lhr-solar/Telemetry/README.md

# Telemetry
Legacy Telemetry Code from BeVolt. Some of this might be useful as a reference for development of future telemetry systems.
