lhr-solar/Telemetry/Senior Design Project 2017/Source Code/STM_Acquisition/nucleo data flow and sw structure.pptx

## Nucleo Acquisition S/W Structure

Main Thread

Initialization

Internal Sensor N

Sample Period

Last Sample Timestamp

DATA

Flag Raised?

FIFO Not Empty?

Create CAN messages Periodic Timer

System Timer

Raises Flag

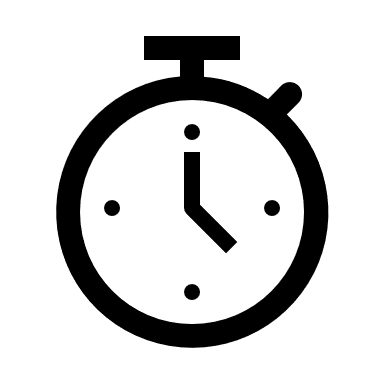
[picture p1: figure]
Stopwatch

Sensor Manager Class

Data

Data

Data

Data

CAN Message Queue Class

CAN Message FIFO

CAN CONTROLLER (WIP)

Input Control

CAN Receive Message
(i.e. Time Sync, etc.)

ID

Output Control

Sensor Data Output on CAN BUS

ID

ID

ID

ID

True

True

## Slide 2

Sensor Class Structure

Sensor Communication Objects
(SPI, I2C, Serial, CAN, Ethernet, … )

Public Functions
Init();
readSensor(timeout_state* pToState, char* pData);
getSizeOfData();

Child Sensor Class

Private Functions
Usually supplied by library as helper functions

SvtSensor Class

bool timeToSample();
void sampleSensor(char * pData);

<Specific> Child Sensor Class
Virtual functions
Init();
readSensor(timeout_state* pToState, char* pData);
getSizeOfData();

ID

Timeout

Sample Period

Last Sample Timestamp

Internal Sensor N

Sample Period

Last Sample Timestamp

DATA

ID

## Open House In-Car Structure

GPS Serial Data

Daughter Board

STM Nucleo

CAN

Send UDP over Ethernet

BPS Serial Data

RPi Hat

Raspberry Pi 3

9DOF I²C Data

Daughter Board

STM Nucleo

Luminosity I²C Data
