lhr-solar/Telemetry/Senior Design Project 2017/Source Code/STM_Acquisition/ourDocumentationImages/nucleo data flow and sw structure.pptx

Main Thread

Initialization

Internal Sensor Data Acquisition

Initialization

CAN Message Creator Thread

Initialization

Timer -> create an array of CAN Messages to reflect the current Sensor States
Sleep Till Timer Event

CANager Thread

Initialization

Timer -> send CAN the next CAN message once the CAN bus is available
Sleep Till Timer Event

Sensor Data Output on CAN BUS

Sensor Bus Protcol #X

External Sensor Data Acquisition
(Timer -> collect data)
Sleep Till Timer Event

Nucleo Data State Class

Data Lock

Sensor Data

CAN Message Queue Class

Data Lock

CAN Message Fifo

## Open House In-Car Structure

GPS Serial Data

Daughter Board

STM Nucleo

CAN

Send UDP over Ethernet

BPS Serial Data

RPi Hat

Raspberry Pi 3

9DOF I²C Data

Daughter Board

STM Nucleo

Luminosity I²C Data

## Slide 3

Main Thread

Initialization

Internal Sensor Data Acquisition

Initialization

CAN Message Creator Thread

Initialization

Timer -> create an array of CAN Messages to reflect the current Sensor States
Sleep Till Timer Event

CANager Thread

Initialization

Timer -> send CAN the next CAN message once the CAN bus is available
Sleep Till Timer Event

Sensor Data Output on CAN BUS

Sensor Bus Protcol #X

External Sensor Data Acquisition
(Timer -> collect data)
Sleep Till Timer Event

Nucleo Data State Class

Data Lock

Sensor Data

CAN Message Queue Class

Data Lock

CAN Message Fifo
