lhr-solar/Telemetry/Senior Design Project 2017/Source Code/STM_Acquisition/STM1.csv

Timestamp, | LIGHT, | ORIENTATION, | GPS,
0, | , | 0, | -90 -59 984 , | 0, | , | 0, | , | 0, | , | 0, | , | 0, | , | 0, | , | 0, | , | 0, | ,
1510002781, | , | 1510002781, | -81 -69 981 , | 1510002781, | , | 1510002781, | , | 1510002781, | , | 1510002781, | , | 1510002781, | , | 1510002781, | , | 1510002781, | , | 1510002781, | ,
1510002782, | , | 1510002782, | -82 -65 982 , | 1510002782, | , | 1510002782, | , | 1510002782, | , | 1510002782, | , | 1510002782, | , | 1510002782, | , | 1510002782, | , | 1510002782, | ,
1510002783, | , | 1510002783, | -80 -68 979 , | 1510002783, | , | 1510002783, | , | 1510002783, | , | 1510002783, | , | 1510002783, | , | 1510002783, | , | 1510002783, | , | 1510002783, | ,
1510002784, | , | 1510002784, | -82 -66 980 , | 1510002784, | , | 1510002784, | , | 1510002784, | , | 1510002784, | , | 1510002784, | , | 1510002784, | , | 1510002784, | , | 1510002784, | ,
0, | , | 0, | -81 -67 980 , | 0, | , | 0, | , | 0, | , | 0, | , | 0, | , | 0, | , | 0, | , | 0, | ,
1510002786, | , | 1510002786, | -80 -66 981 , | 1510002786, | , | 1510002786, | , | 1510002786, | , | 1510002786, | , | 1510002786, | , | 1510002786, | , | 1510002786, | , | 1510002786, | ,
1510002787, | , | 1510002787, | -80 -67 978 , | 1510002787, | , | 1510002787, | , | 1510002787, | , | 1510002787, | , | 1510002787, | , | 1510002787, | , | 1510002787, | , | 1510002787, | ,
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
1510002804, | , | 1510002804, | -76 -73 980 , | 1510002804, | , | 1510002804, | , | 1510002804, | , | 1510002804, | , | 1510002804, | , | 1510002804, | , | 1510002804, | , | 1510002804, | ,
