lhr-solar/Telemetry/RP3 Demo/grafana-dash.png

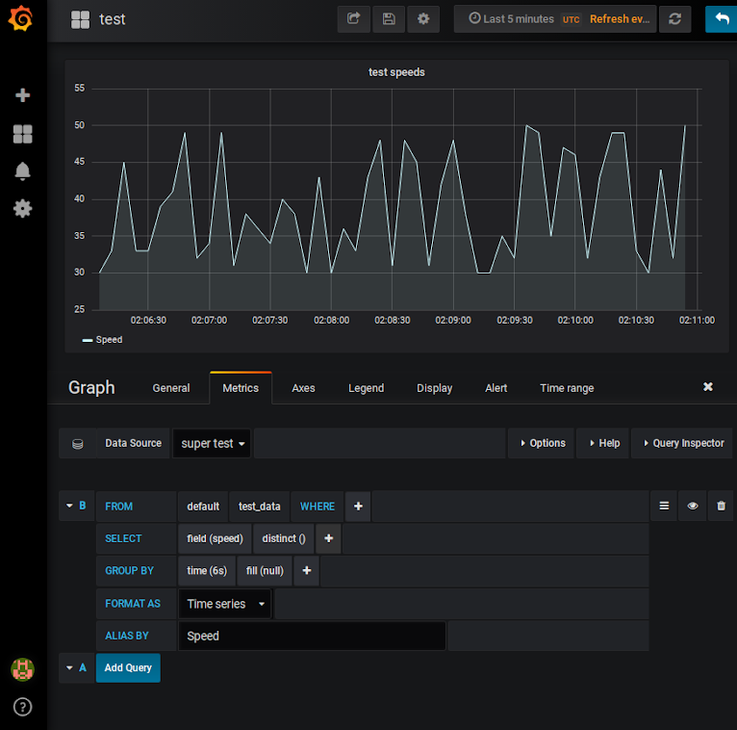
RP3 Demo/grafana-dash.png
