lhr-solar/Telemetry/RP3 Demo/grafana_settings.png

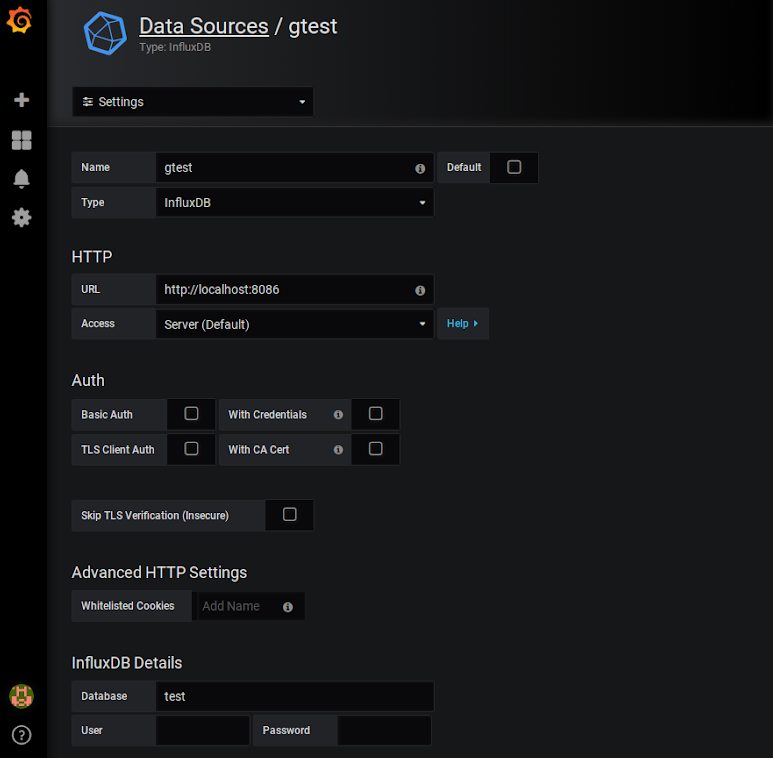
RP3 Demo/grafana_settings.png
