lhr-solar/Telemetry/Senior Design Project 2017/Source Code/Display/TestingLogs/concurrent.xlsx

Seconds | InfluxDB |  |  |  |  | Grafana |  |  |  |  | Python
 | VIRT | RES | SHR | %CPU | %MEM | VIRT | RES | SHR | %CPU | %MEM | VIRT | RES | SHR | %CPU | %MEM
0 | 824424 | 50824 | 10056 | 0 | 5.4 | 900836 | 26852 | 14756 | 0 | 2.8 | 16812 | 13016 | 6220 | 0 | 1.4
5 | 824424 | 50824 | 10056 | 3 | 5.4 | 900836 | 26852 | 14756 | 0.4 | 2.8 | 16812 | 13016 | 6220 | 1.2 | 1.4
10 | 824424 | 50824 | 10056 | 1 | 5.4 | 900836 | 26852 | 14756 | 0.2 | 2.8 | 16812 | 13016 | 6220 | 1.4 | 1.4
15 | 824424 | 51836 | 10444 | 15.9 | 5.5 | 900836 | 26852 | 14756 | 1.4 | 2.8 | 16812 | 13016 | 6220 | 1.2 | 1.4
20 | 824424 | 57696 | 10848 | 75.6 | 6.1 | 900836 | 26852 | 14756 | 1.4 | 2.8 | 16812 | 13016 | 6220 | 1.6 | 1.4
25 | 824424 | 57696 | 10848 | 3 | 6.1 | 900836 | 26852 | 14756 | 0.4 | 2.8 | 16812 | 13016 | 6220 | 1.6 | 1.4
30 | 824424 | 67560 | 10988 | 165.9 | 7.1 | 900836 | 26852 | 14756 | 1.4 | 2.8 | 16812 | 13016 | 6220 | 1.6 | 1.4
35 | 824424 | 68084 | 10988 | 9.5 | 7.2 | 900836 | 26852 | 14756 | 2.8 | 2.8 | 16812 | 13016 | 6220 | 1.6 | 1.4
40 | 824424 | 69396 | 10988 | 3.8 | 7.3 | 900836 | 26852 | 14756 | 1 | 2.8 | 16812 | 13016 | 6220 | 1.6 | 1.4
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
