lhr-solar/Telemetry/(threads)

Thread 2 (2020-06-04):

Radio assessment needed.

chaseblock, 2020-06-04:
The radios that we currently have set up are the FGRplus RE Industrial 900 MHz Radios. There is a data sheet for them available [here](https://drive.google.com/file/d/14AX2NCyfy-EcmtgY6p72VD--s-y5eGoF/view?usp=sharing).

These are pretty old, and so we want to know
1. How far does the range on these cover? Will we be able to communicate from the other side of the track, or only for a few seconds during each lap?
2. How reliable are these? Will we have a strong connection a few meters from the car, or will it be spotty?
3. How will these be mounted where we need them?

Thread 3 (2020-06-04):

Two-way radios

chaseblock, 2020-06-04:
We need two-way radios so that our driver and support crew can communicate with each other.

Questions that need answering:
1. What radio system could we use? This should be hands free (other than a toggle button if necessary).
2. How will we power these radios?
3. What range would these have? What range would be required?

Thread 4 (2020-06-04):

Package the RPi system into a portable device.

chaseblock, 2020-06-04:
We should configure the raspberry pi telemetry system, as well as any components it depends upon to be as portable as possible. Some ideas:

* If the energy consumption is low, a chargeable battery pack could provide portability for short to medium time lengths.
* A case containing the Pi to protect it would be nice. If the battery idea is taken, perhaps the case could include the battery as well, exposing a port for charging and whatever IO is require for functionality.
* Any external components should be easy to carry and set up. If there is a lot of equipment that we need to be carrying, perhaps a dedicated case for carrying the system could be used. Maybe something like [this](https://tr2.cbsistatic.com/hub/i/2006/06/21/45fcee98-c3c1-11e2-bc00-02911874f8c8/f550641443d1835bbe2622d6cd096ec3/425482315WmOHnk_ph.jpg) (except with our radio/pi system inside).

These are some ideas, and I'm interested to hear what others think.
