lhr-solar/Telemetry/Senior Design Project 2017/Schematics/DipTrace PCB - daughterboard.dip.pdf

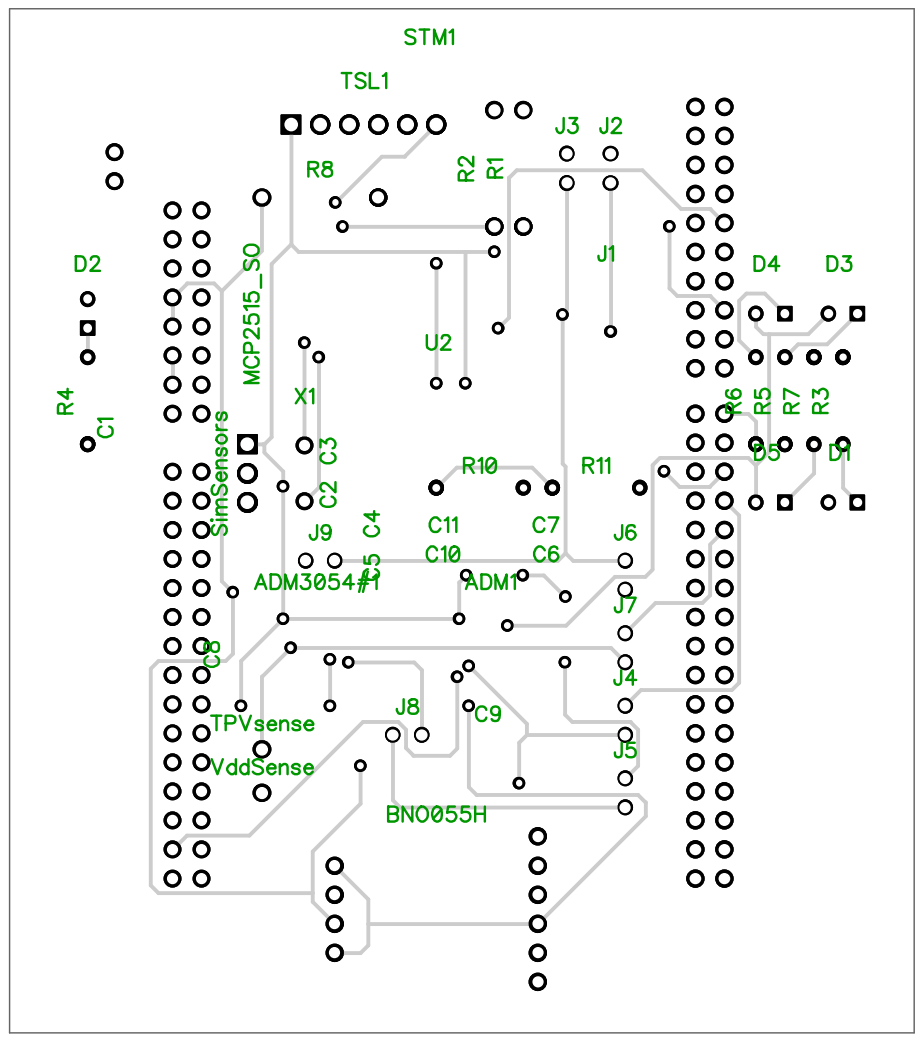
[picture p25: page 1]
