lhr-solar/Telemetry/Senior Design Project 2017/Schematics/senior_fall17_ telemetry_sch.pdf

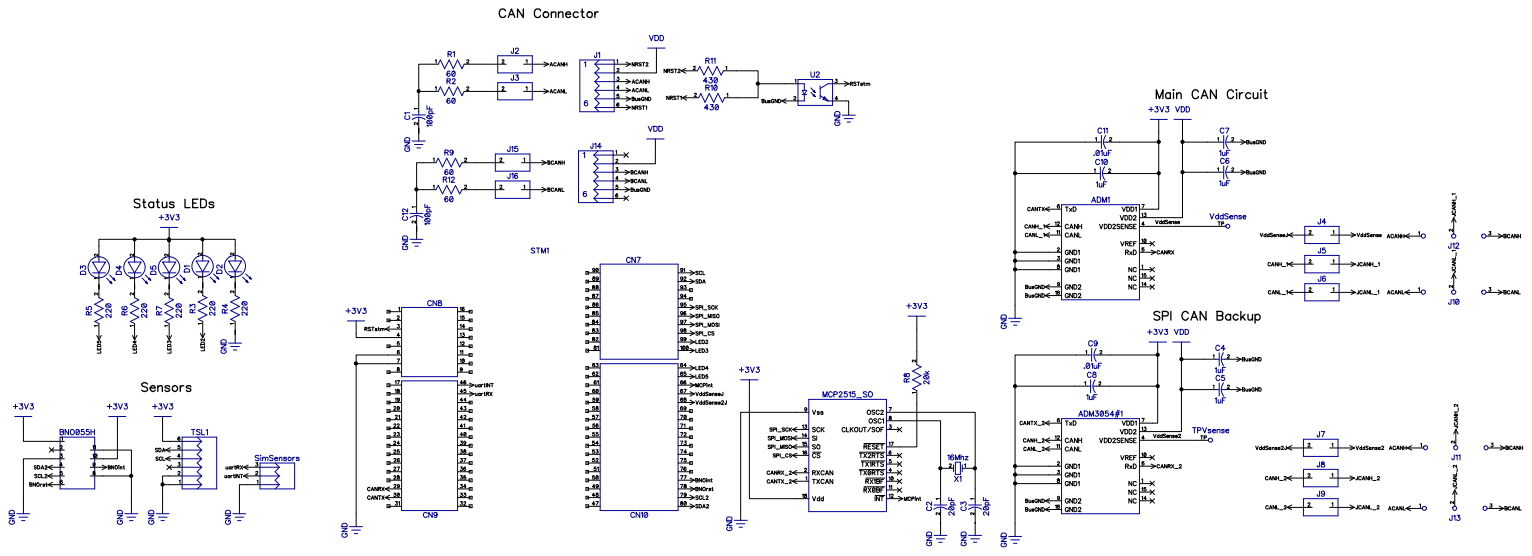
[picture p26: page 1]
