lhr-solar/Telemetry/Senior Design Project 2017/Schematics/senior_fall17_telemetry_pcb_top.pdf

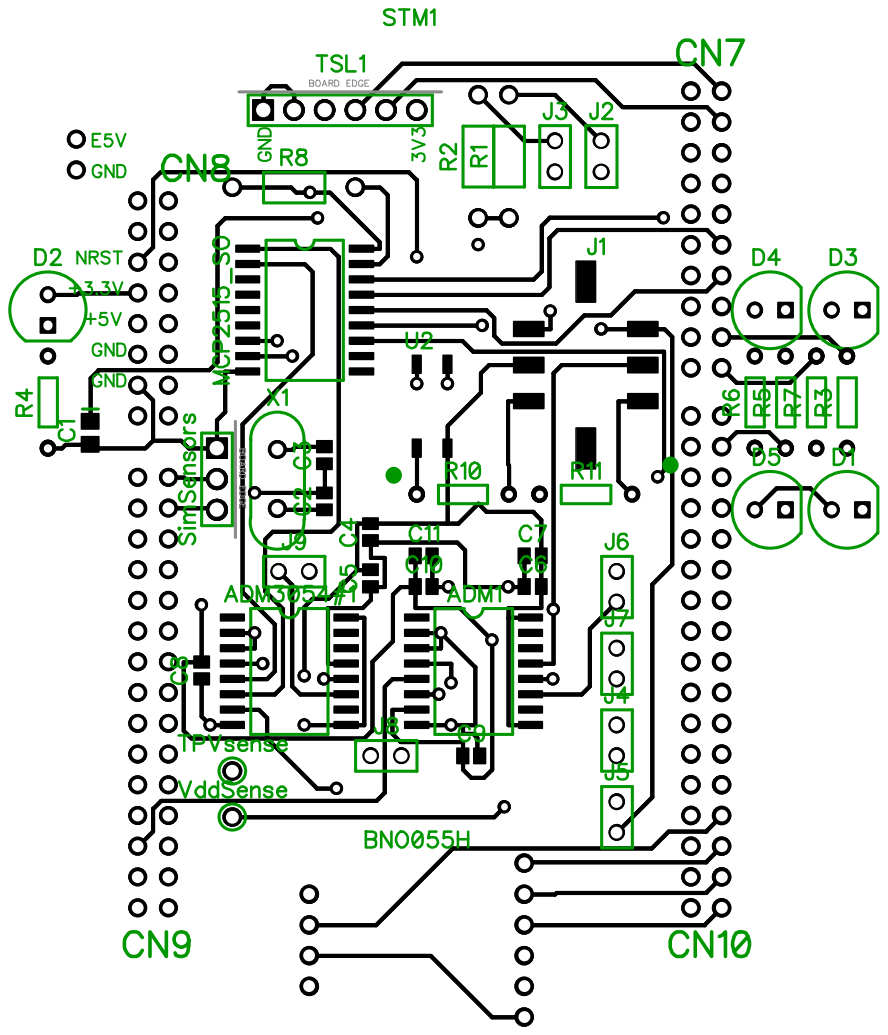
[picture p27: page 1]
