lhr-solar/Telemetry/Senior Design Project 2017/Schematics/RPI3HatV1.2/RPi3HatV1.2.pdf

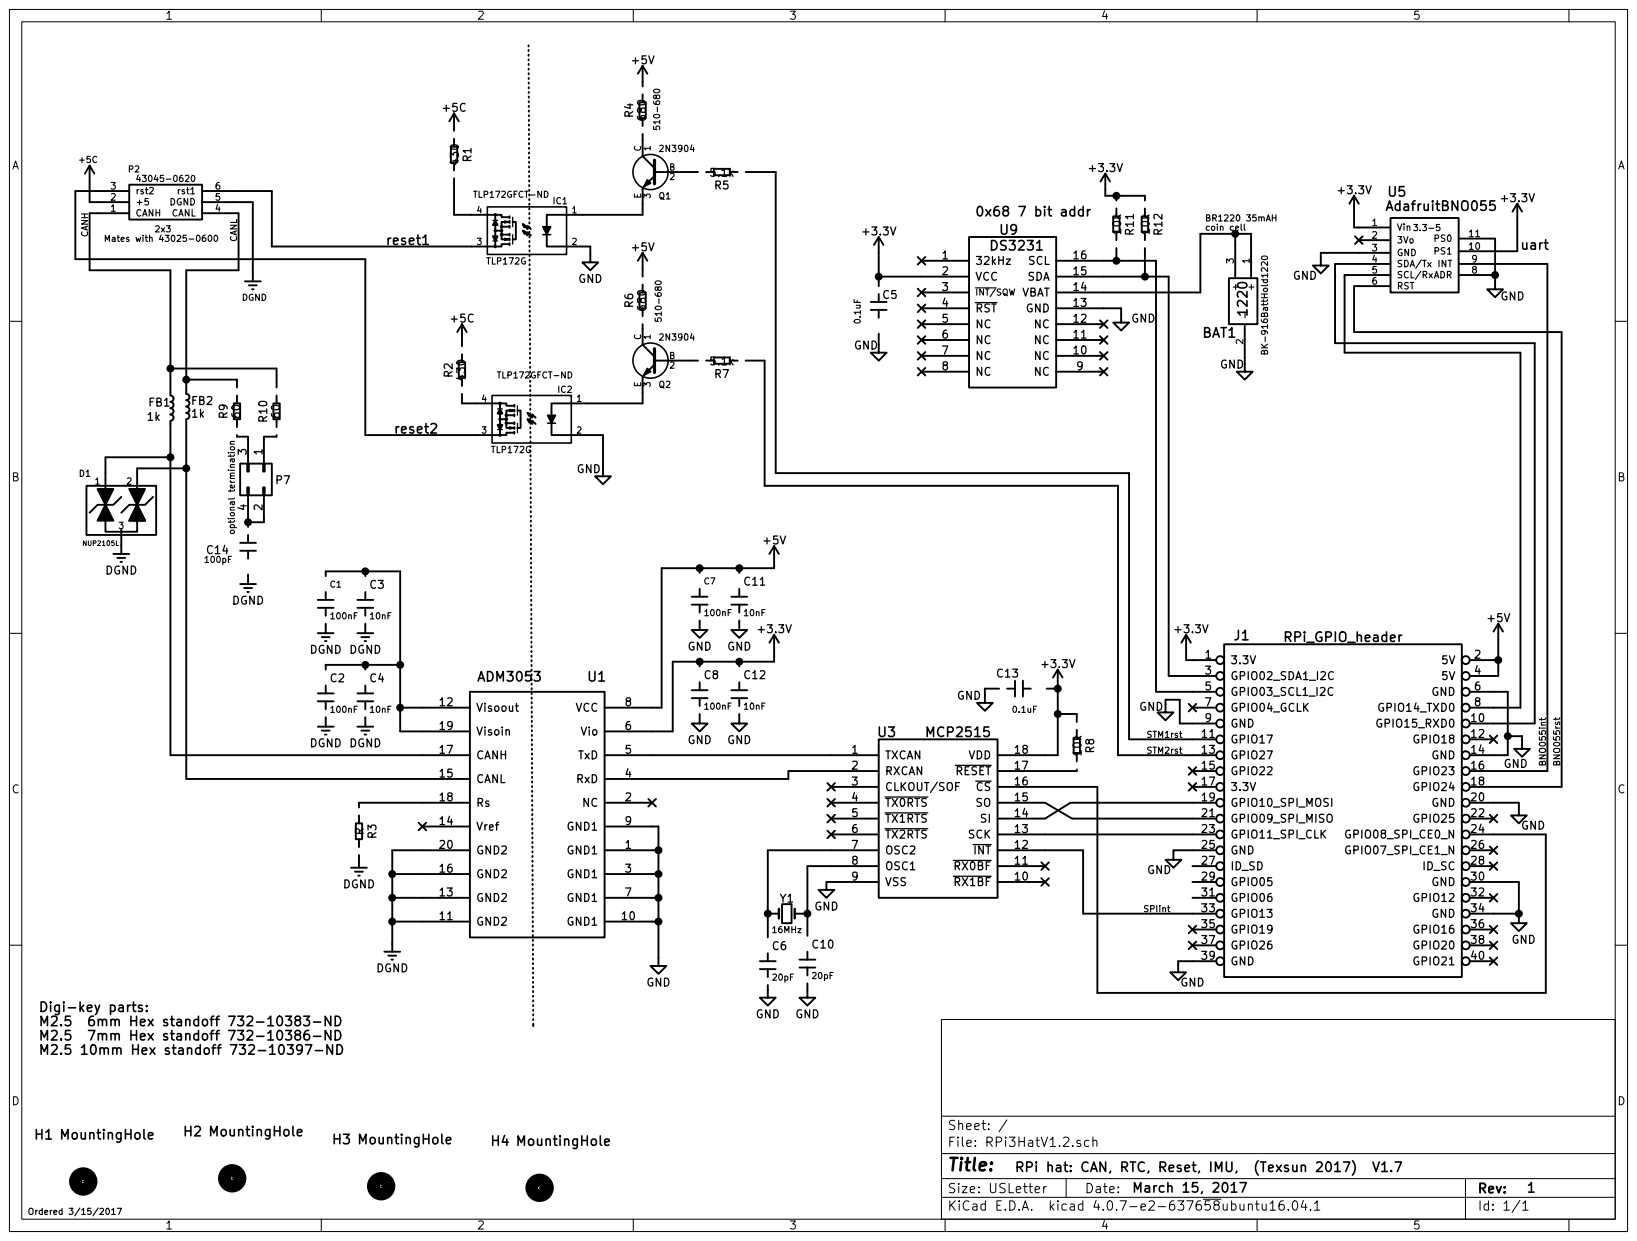
[picture p28: page 1]
