lhr-solar/Telemetry/(list of files, drawings)

Other design files:
Senior Design Project 2017/Schematics/RPI3HatV1.2/RPi3HatV1.2.dsn
Senior Design Project 2017/Source Code/STM_DaughterBoard/daughterboard.dip
Senior Design Project 2017/Source Code/STM_DaughterBoard/STM32Nucleo.pcb
Senior Design Project 2017/Source Code/STM_DaughterBoard/STMdaughterBoard.dch
