lhr-solar/Telemetry/Senior Design Project 2017/Schematics/RPI3HatV1.2/RPi3HatV1.2.kicad_pcb

## KiCad design Senior Design Project 2017/Schematics/RPI3HatV1.2/RPi3HatV1.2.kicad_pcb (2019-02-08)

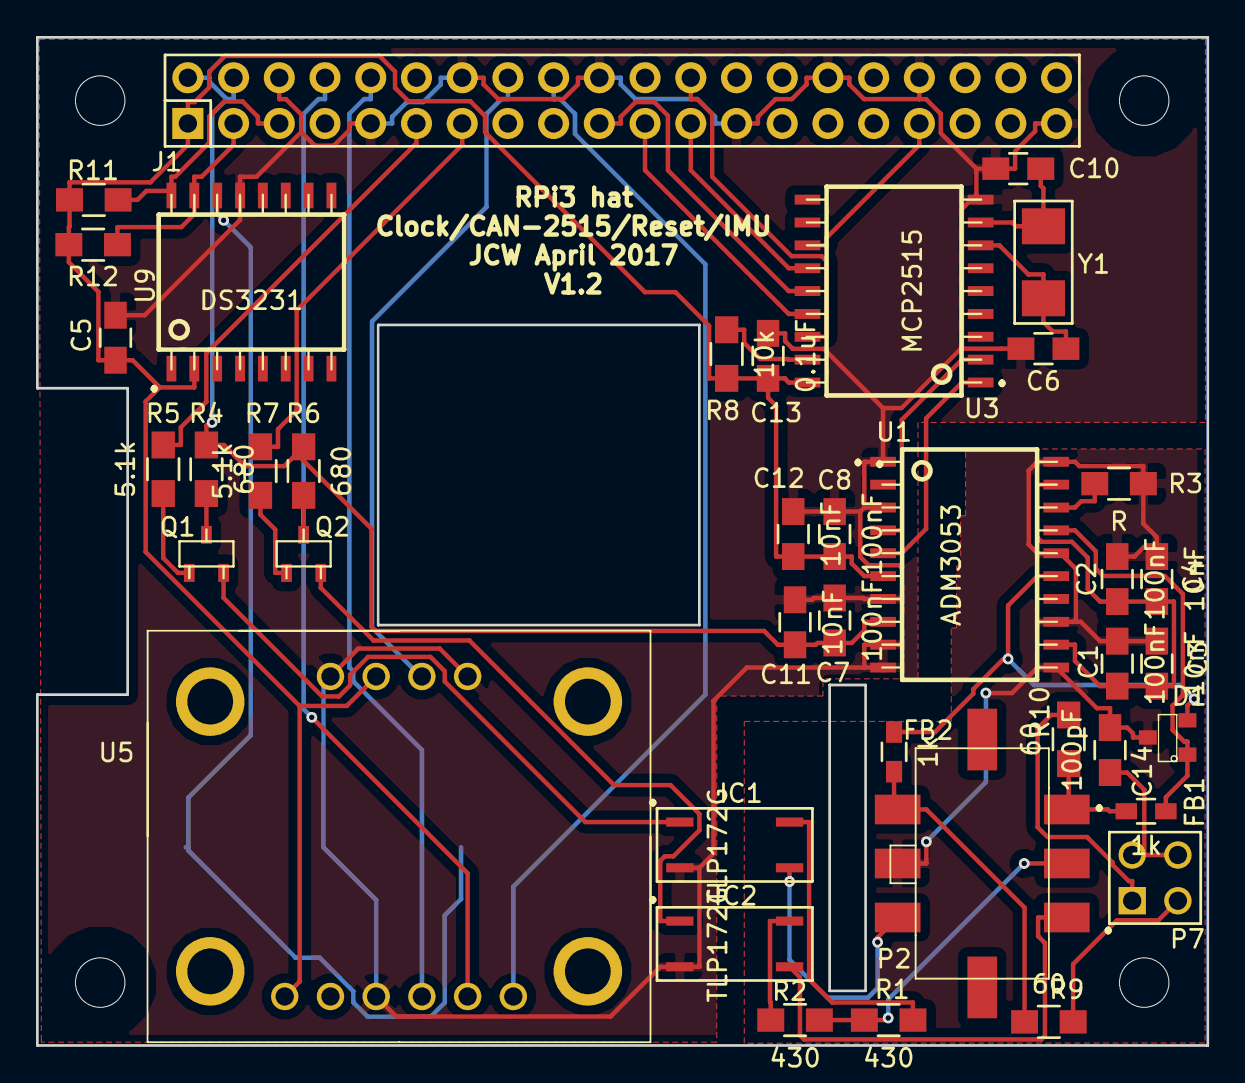
[picture p29: board RPi3HatV1.2.kicad_pcb from above]

Board: 2 copper layers, 65.0 x 56.0 mm, 45 parts (1 on the bottom side), 43 nets.

Parts:
BAT1: BK-916BattHold1220; BK-916BatClip1220
C1, C2, C7, C8: 100nF; C_0805_HandSoldering
C3, C4, C11, C12: 10nF; C_0805_HandSoldering
C5, C13: 0.1uF; C_0805_HandSoldering
C6, C10: 20pF; C_0805_HandSoldering
C14: 100pF; C_0805_HandSoldering
D1: NUP2105L; SOT23-1700
FB1, FB2: 1k; R_0603_HandSoldering
H1, H2, H3, H4: MountingHole; RPi_Hat_Mounting_Hole
IC1, IC2: TLP172G; 2.54SOP4
J1: RPi_GPIO_header; Pin_Header_Straight_2x20
P2: 43045-0620; 43045-0620header6pin
P7: optional termination; pin_array_2x02
Q1, Q2: 2N3904; sot23_b
R1, R2: 430; R_0805_HandSoldering
R3: R; R_0805_HandSoldering
R4, R6: 680; R_0805_HandSoldering
R5, R7: 5.1k; R_0805_HandSoldering
R8, R11, R12: 10k; R_0805_HandSoldering
R9, R10: 60; R_0805_HandSoldering
U1: ADM3053; soic-20
U3: MCP2515; soic-18
U5: AdafruitBNO055; BDO055BOB
U9: DS3231; soic-16
Y1: 16MHz; 2SMD

Connections:
+3V3: C5.2, C8.1, C12.1, C13.1, J1.1, R8.1, R11.1, R12.1, U1.6, U3.18, U5.1, U5.10, U9.2
+5C: P2.2, R1.1, R2.2
+5V: C7.1, C11.1, J1.2, J1.4, R4.2, R6.2, U1.8
/BNO055int: J1.16, U5.9
/BNO055rst: J1.18, U5.6
/CANH: FB1.1, P2.1, R10.2
/CANL: FB2.1, P2.4, R9.2
/SPIint: J1.33, U3.12
/STM1rst: J1.11, R5.1
/STM2rst: J1.13, R7.1
/reset1: IC1.3, P2.6
/reset2: IC2.3, P2.3
GND: BAT1.2, C5.1, C6.2, C7.2, C8.2, C10.2, C11.2, C12.2, C13.2, IC1.2, IC2.2, J1.6, J1.9, J1.14, J1.20, J1.25, J1.30, J1.34, J1.39, U1.1, U1.3, U1.7, U1.9, U1.10, U3.9, U5.3, U5.8, U5.11, U9.13
GNDREF: C1.2, C2.2, C3.2, C4.2, C14.1, D1.3, P2.5, R3.2, U1.11, U1.13, U1.16, U1.20
unnamed: BAT1.1, BAT1.3, U9.14
unnamed: C1.1, C2.1, C3.1, C4.1, U1.12, U1.19
unnamed: C6.1, U3.7, Y1.1
unnamed: C10.1, U3.8, Y1.2
unnamed: C14.2, P7.2, P7.4
unnamed: D1.1, FB1.2, U1.17
unnamed: D1.2, FB2.2, U1.15
unnamed: IC1.1, Q1.3
unnamed: IC1.4, R1.2
unnamed: IC2.1, Q2.3
unnamed: IC2.4, R2.1
unnamed: J1.3, R12.2, U9.15
unnamed: J1.5, R11.2, U9.16
unnamed: J1.8, U5.5
unnamed: J1.10, U5.4
unnamed: J1.19, U3.14
unnamed: J1.21, U3.15
unnamed: J1.23, U3.13
unnamed: J1.24, U3.16
unnamed: P7.1, R10.1
unnamed: P7.3, R9.1
unnamed: Q1.1, R4.1
unnamed: Q1.2, R5.2
unnamed: Q2.1, R6.1
unnamed: Q2.2, R7.2
unnamed: R3.1, U1.18
unnamed: R8.2, U3.17
unnamed: U1.4, U3.2
unnamed: U1.5, U3.1
