lhr-solar/Telemetry/Raspberry Pi Telemetry Server/mbed-os-example-udp-sockets/mbed_config.h

/*
 * mbed SDK
 * Copyright (c) 2017 ARM Limited
 *
 * Licensed under the Apache License, Version 2.0 (the "License");
 * you may not use this file except in compliance with the License.
 * You may obtain a copy of the License at
 *
 * http://www.apache.org/licenses/LICENSE-2.0
 *
 * Unless required by applicable law or agreed to in writing, software
 * distributed under the License is distributed on an "AS IS" BASIS,
 * WITHOUT WARRANTIES OR CONDITIONS OF ANY KIND, either express or implied.
 * See the License for the specific language governing permissions and
 * limitations under the License.
 */

// Automatically generated configuration file.
// DO NOT EDIT, content will be overwritten.

#ifndef __MBED_CONFIG_DATA__
#define __MBED_CONFIG_DATA__

// Configuration parameters
#define CLOCK_SOURCE                                      USE_PLL_HSE_EXTC|USE_PLL_HSI // set by target:NUCLEO_F429ZI
#define CLOCK_SOURCE_USB                                  1                            // set by target:NUCLEO_F429ZI
#define MBED_CONF_DRIVERS_UART_SERIAL_RXBUF_SIZE          256                          // set by library:drivers
#define MBED_CONF_DRIVERS_UART_SERIAL_TXBUF_SIZE          256                          // set by library:drivers
#define MBED_CONF_EVENTS_PRESENT                          1                            // set by library:events
#define MBED_CONF_EVENTS_SHARED_DISPATCH_FROM_APPLICATION 0                            // set by library:events
#define MBED_CONF_EVENTS_SHARED_EVENTSIZE                 256                          // set by library:events
#define MBED_CONF_EVENTS_SHARED_HIGHPRIO_EVENTSIZE        256                          // set by library:events
#define MBED_CONF_EVENTS_SHARED_HIGHPRIO_STACKSIZE        1024                         // set by library:events
#define MBED_CONF_EVENTS_SHARED_STACKSIZE                 1024                         // set by library:events
#define MBED_CONF_FILESYSTEM_PRESENT                      1                            // set by library:filesystem
#define MBED_CONF_LWIP_ADDR_TIMEOUT                       5                            // set by library:lwip
#define MBED_CONF_LWIP_ADDR_TIMEOUT_MODE                  1                            // set by library:lwip
#define MBED_CONF_LWIP_DEBUG_ENABLED                      0                            // set by library:lwip
#define MBED_CONF_LWIP_DEFAULT_THREAD_STACKSIZE           512                          // set by library:lwip
#define MBED_CONF_LWIP_ENABLE_PPP_TRACE                   0                            // set by library:lwip
#define MBED_CONF_LWIP_ETHERNET_ENABLED                   1                            // set by library:lwip
#define MBED_CONF_LWIP_IPV4_ENABLED                       1                            // set by library:lwip
#define MBED_CONF_LWIP_IPV6_ENABLED                       0                            // set by library:lwip
#define MBED_CONF_LWIP_IP_VER_PREF                        4                            // set by library:lwip
#define MBED_CONF_LWIP_PPP_THREAD_STACKSIZE               768                          // set by library:lwip
#define MBED_CONF_LWIP_SOCKET_MAX                         4                            // set by library:lwip
#define MBED_CONF_LWIP_TCPIP_THREAD_STACKSIZE             1200                         // set by library:lwip
#define MBED_CONF_LWIP_TCP_ENABLED                        1                            // set by library:lwip
#define MBED_CONF_LWIP_TCP_SERVER_MAX                     4                            // set by library:lwip
#define MBED_CONF_LWIP_TCP_SOCKET_MAX                     4                            // set by library:lwip
#define MBED_CONF_LWIP_UDP_SOCKET_MAX                     4                            // set by library:lwip
#define MBED_CONF_LWIP_USE_MBED_TRACE                     0                            // set by library:lwip
#define MBED_CONF_NSAPI_PRESENT                           1                            // set by library:nsapi
#define MBED_CONF_PLATFORM_DEFAULT_SERIAL_BAUD_RATE       9600                         // set by library:platform
#define MBED_CONF_PLATFORM_STDIO_BAUD_RATE                9600                         // set by library:platform
#define MBED_CONF_PLATFORM_STDIO_CONVERT_NEWLINES         0                            // set by library:platform
#define MBED_CONF_PLATFORM_STDIO_FLUSH_AT_EXIT            1                            // set by library:platform
#define MBED_CONF_PPP_CELL_IFACE_APN_LOOKUP               0                            // set by library:ppp-cell-iface
#define MBED_CONF_PPP_CELL_IFACE_AT_PARSER_BUFFER_SIZE    256                          // set by library:ppp-cell-iface
#define MBED_CONF_PPP_CELL_IFACE_AT_PARSER_TIMEOUT        8000                         // set by library:ppp-cell-iface
#define MBED_CONF_PPP_CELL_IFACE_BAUD_RATE                115200                       // set by library:ppp-cell-iface
#define MBED_CONF_RTOS_PRESENT                            1                            // set by library:rtos
#define NSAPI_PPP_AVAILABLE                               0                            // set by library:lwip
#define NSAPI_PPP_IPV4_AVAILABLE                          1                            // set by library:lwip
#define NSAPI_PPP_IPV6_AVAILABLE                          0                            // set by library:lwip
#define STM32_D11_SPI_ETHERNET_PIN                        PA_7                         // set by target:NUCLEO_F429ZI
// Macros
#define UNITY_INCLUDE_CONFIG_H                                                         // defined by library:utest

#endif
