lhr-solar/Telemetry/(commit log)

2019-02-08 Deleted Files
    [BOM.csv, BOM.xlsx, BOMtesterboard.xlsx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]
2019-02-08 Added all material for current system
    [RPi3HatV1.2-B.Cu.gbl, RPi3HatV1.2-B.Mask.gbs, RPi3HatV1.2-B.SilkS.gbo, RPi3HatV1.2-Edge.Cuts.gm1, RPi3HatV1.2-F.Cu.gtl, RPi3HatV1.2-F.Mask.gts, RPi3HatV1.2-F.SilkS.gto, RPi3HatV1.2.drl]
2019-09-21 Added files for raspberry pi telemtry server project. Also added a Readme that describes how to set up and run the system.
2019-11-02 Added python file for web scraping, updated the start up script to use this file instead of the udp socket file
2019-11-23 updated parsing of webpage to parse the whole page. Changed code for webscraping but it is not working yet. Not sure if this is an issue with the raspberry pi system or the telemetry system on the nu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
2019-12-08 Changed file to reflect that it stops the web scraper and no longer stops the socket
